WB2CBA/TI-DUINO-SR-10-VINTAGE-CALCULATOR-CLONE/TI_DUINO SR10 TOP COVER.jpg

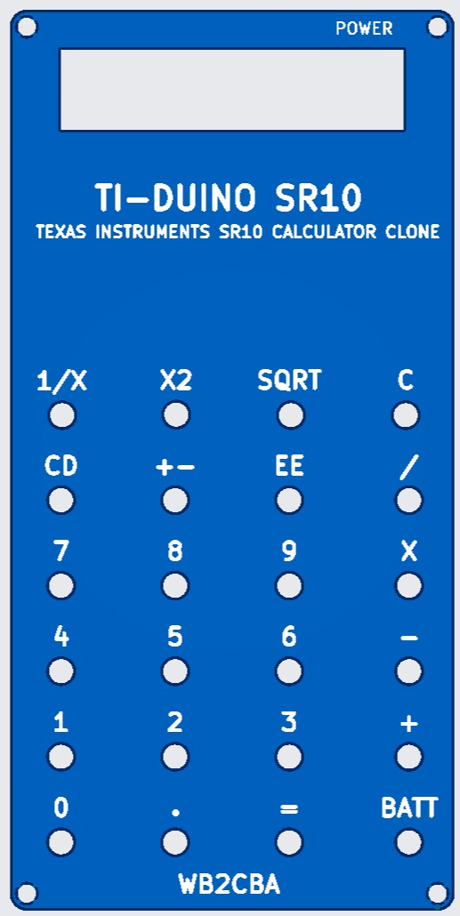
TI_DUINO SR10 TOP COVER.jpg
