WB2CBA/TI-DUINO-SR-10-VINTAGE-CALCULATOR-CLONE/Top+null+SMT026100664891.png

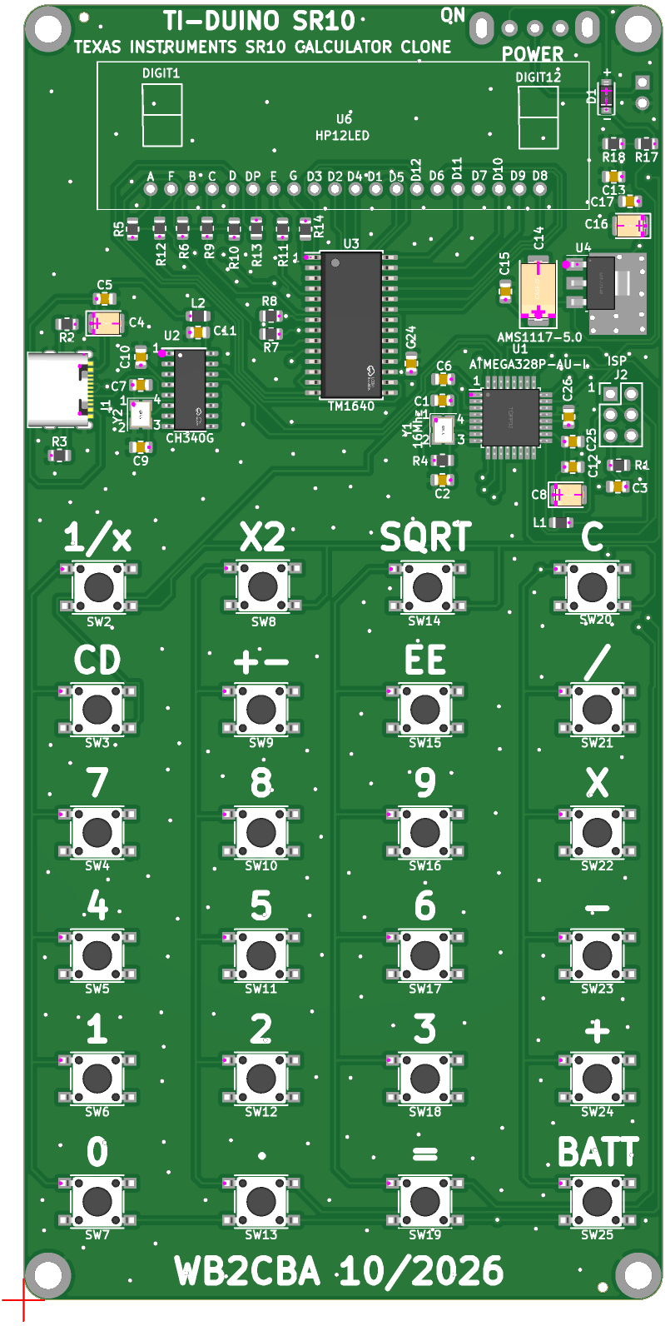
Top+null+SMT026100664891.png
