WB2CBA/TI-DUINO-SR-10-VINTAGE-CALCULATOR-CLONE/FABRICATION FILES/BOM CALC.csv

Comment | Designator | Footprint | LCSC
10uF/16V | C16 | Capacitor_Tantalum_SMD:CP_EIA-3528-21_Kemet-B | C110050
22pF | C1,C2,C7,C9 | Capacitor_SMD:C_0805_2012Metric | C1804
100nF | C3,C5,C6,C10,C11,C12,C13,C15,C17,C24,C25,C26 | Capacitor_SMD:C_0805_2012Metric | C28233
100uF/16V | C4,C8 | Capacitor_Tantalum_SMD:CP_EIA-3528-21_Kemet-B | C16133
1N5819 | D1 | Diode_SMD:D_SOD-123 | C82544
USB_C_Receptacle_USB2.0 | J1 | Connector_USB:USB_C_Receptacle_XKB_U262-16XN-4BVC11 | C393939
100uH | L1,L2 | Inductor_SMD:L_0805_2012Metric | C223143
10k | R1,R7,R8 | Resistor_SMD:R_0805_2012Metric | C17414
220k | R17 | Resistor_SMD:R_0805_2012Metric | C17556
100k | R18 | Resistor_SMD:R_0805_2012Metric | C149504
5.1k | R2,R3 | Resistor_SMD:R_0805_2012Metric | C27834
1M | R4 | Resistor_SMD:R_0805_2012Metric | C17514
330R | R5,R6,R9,R10,R11,R12,R13,R14 | Resistor_SMD:R_0805_2012Metric | C17630
 | SW2,SW3,SW4,SW5,SW6,SW7,SW8,SW9,SW10,SW11,SW12,SW13,SW14,SW15,SW16,SW17,SW18,SW19,SW20,SW21,SW22,SW23,SW24,SW25 | Button_Switch_SMD:SW_Push_1P1T_NO_6x6mm_H9.5mm | C455118
ATMEGA328P-AU-L | U1 | Package_QFP:TQFP-32_7x7mm_P0.8mm | C14877
CH340G | U2 | Package_SO:SOIC-16_3.9x9.9mm_P1.27mm | C14267
TM1640 | U3 | Package_SO:SOIC-28W_7.5x17.9mm_P1.27mm | C5337152
AMS1117-5.0 | U4 | Package_TO_SOT_SMD:SOT-223-3_TabPin2 | C6187
16Mhz | Y1 | Crystal:Crystal_SMD_SeikoEpson_FA238-4Pin_3.2x2.5mm | C13738
12Mhz | Y2 | Crystal:Crystal_SMD_SeikoEpson_FA238-4Pin_3.2x2.5mm | C9002
100uF/16V | C14 | Capacitor_Tantalum_SMD:CP_EIA-7343-31_Kemet-D_Pad2.25x2.55mm_HandSolder | C7223
