WB2CBA/TI-DUINO-SR-10-VINTAGE-CALCULATOR-CLONE/TI-DUINO SR_10 with TM1640 and  9V Batt SCHEMATIC.pdf

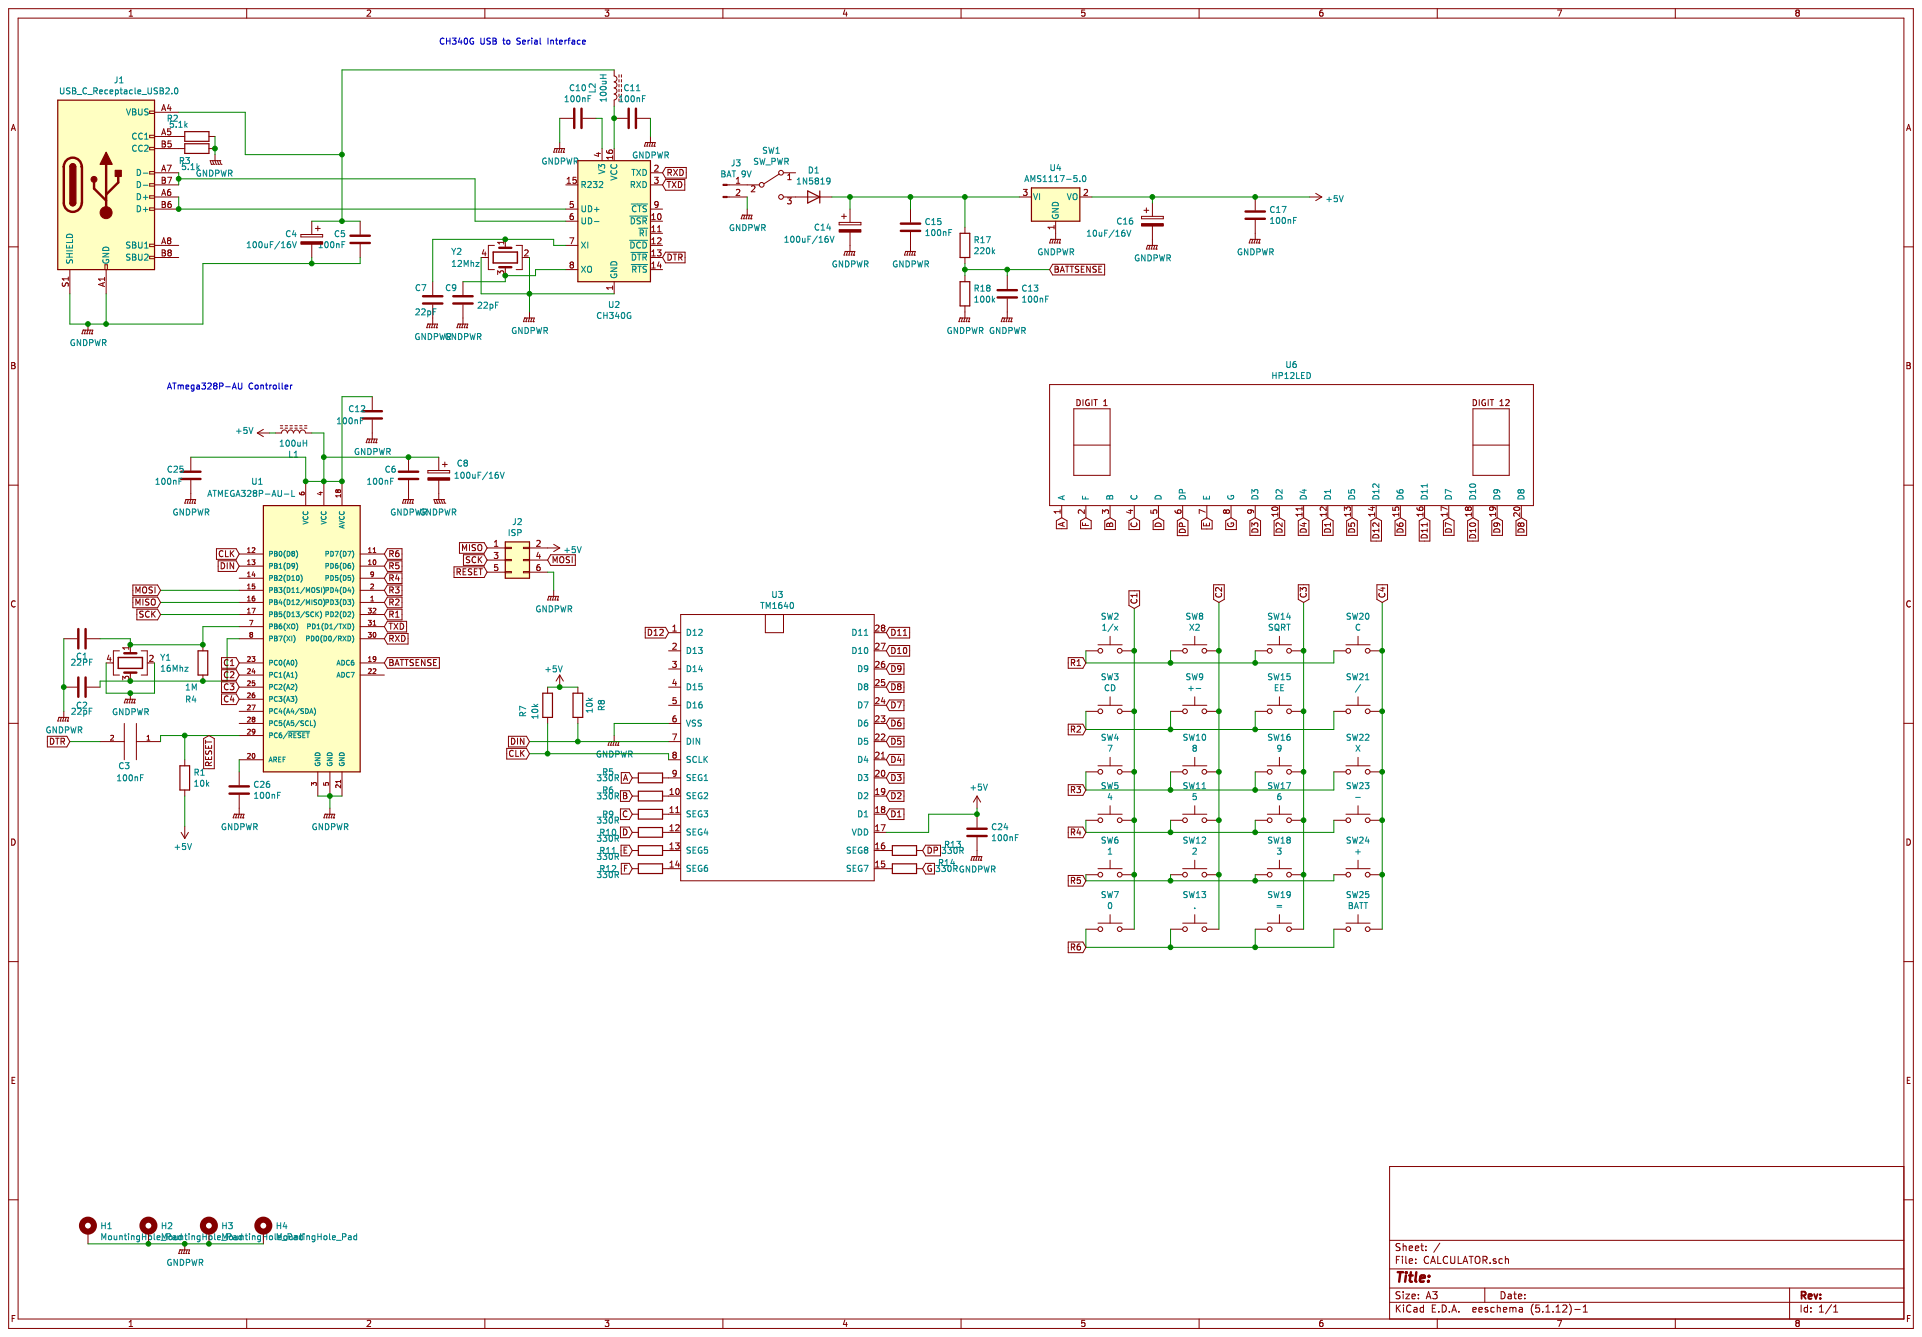
[picture p5: page 1]
